divu1249/Retro-Console-using-UART-ESP32-C3-and-ESP8266-Lolin/firmware/esp32-c3-console/data/wallpaper_preview.jpeg

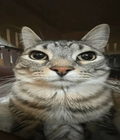
firmware/esp32-c3-console/data/wallpaper_preview.jpeg
