divu1249/Retro-Console-using-UART-ESP32-C3-and-ESP8266-Lolin/hardware/schematics/prototype_dimensions.jpeg

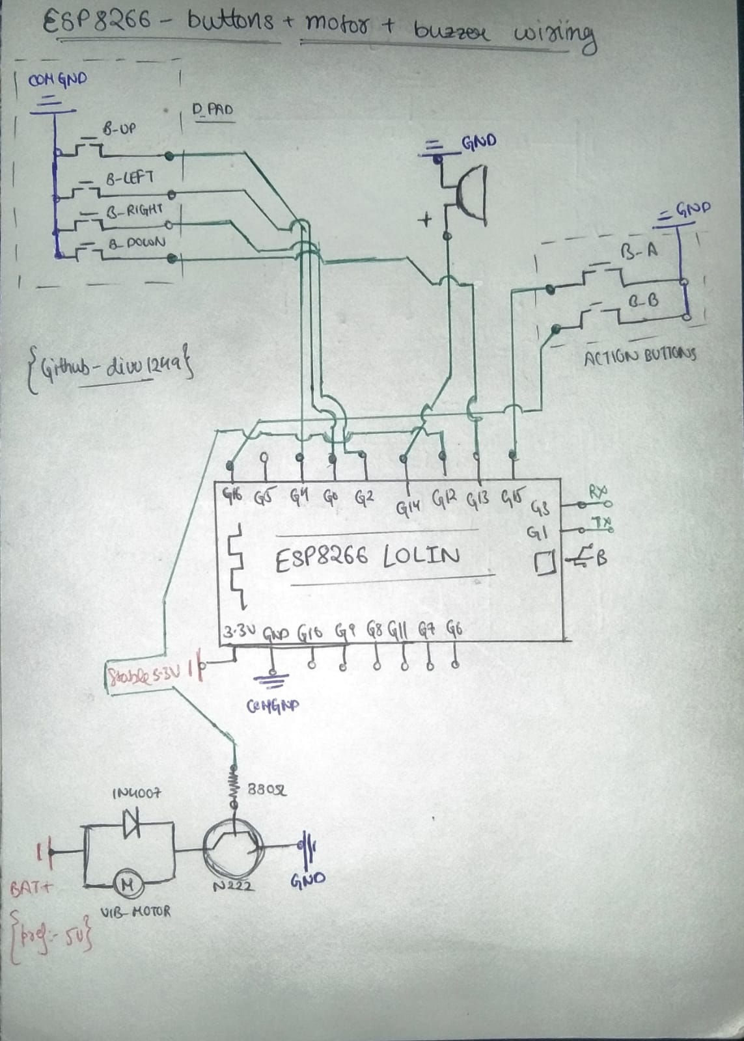
hardware/schematics/prototype_dimensions.jpeg
