divu1249/Retro-Console-using-UART-ESP32-C3-and-ESP8266-Lolin/hardware/schematics/complete-console-wiring.jpeg

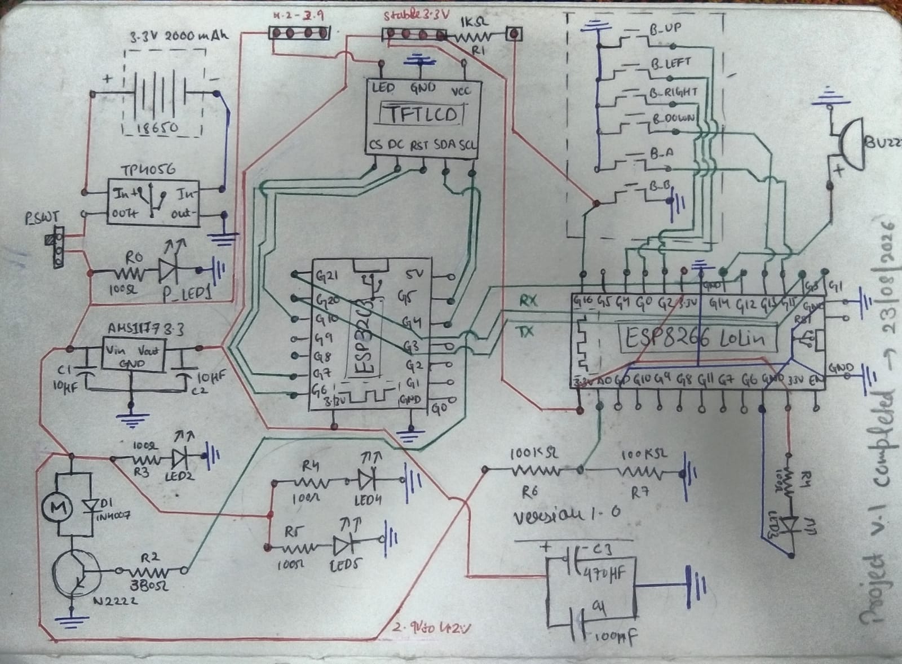
hardware/schematics/complete-console-wiring.jpeg
