divu1249/Retro-Console-using-UART-ESP32-C3-and-ESP8266-Lolin/hardware/schematics/esp32-c3-tft-wiring.jpeg

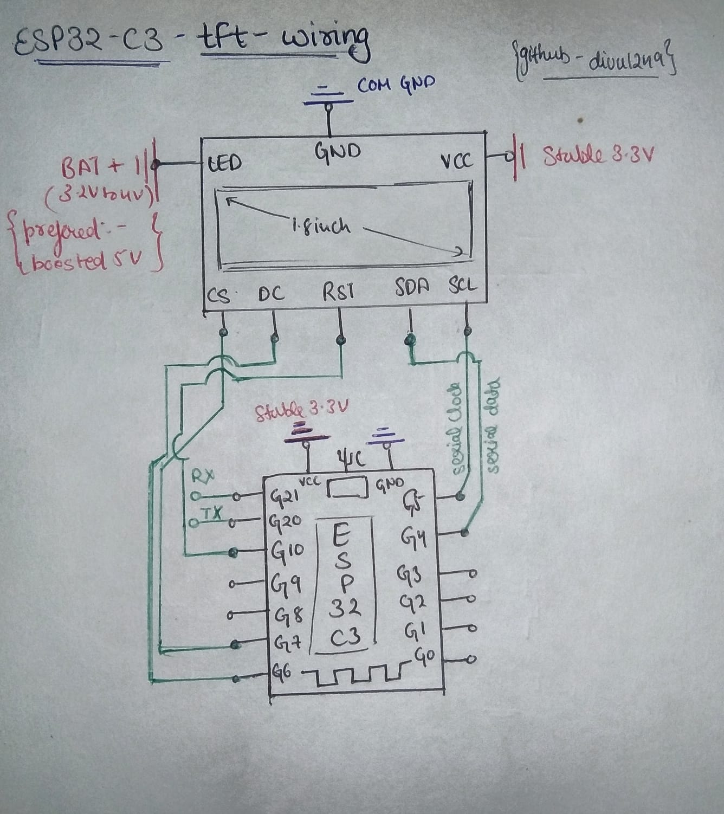
hardware/schematics/esp32-c3-tft-wiring.jpeg
